rileytuttle/order66-pcb/order66/order66-back-pcb.png

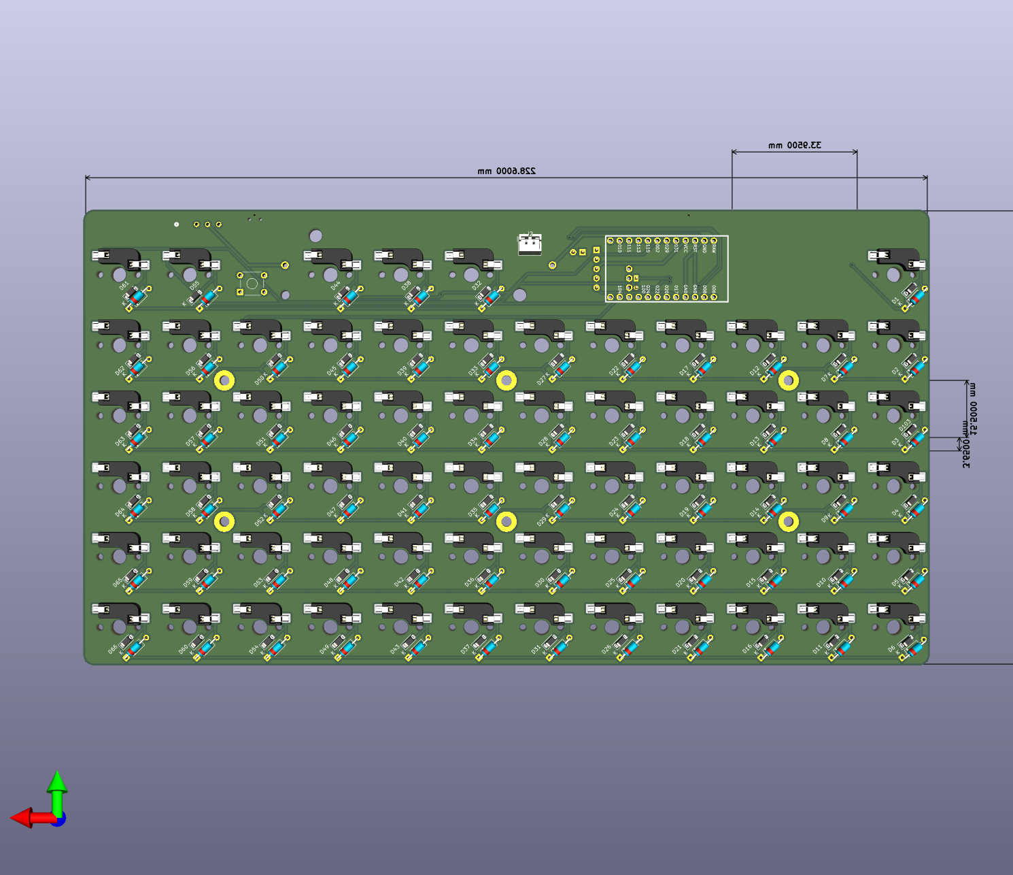
order66/order66-back-pcb.png
