rileytuttle/order66-pcb/order66/order66-front-pcb.png

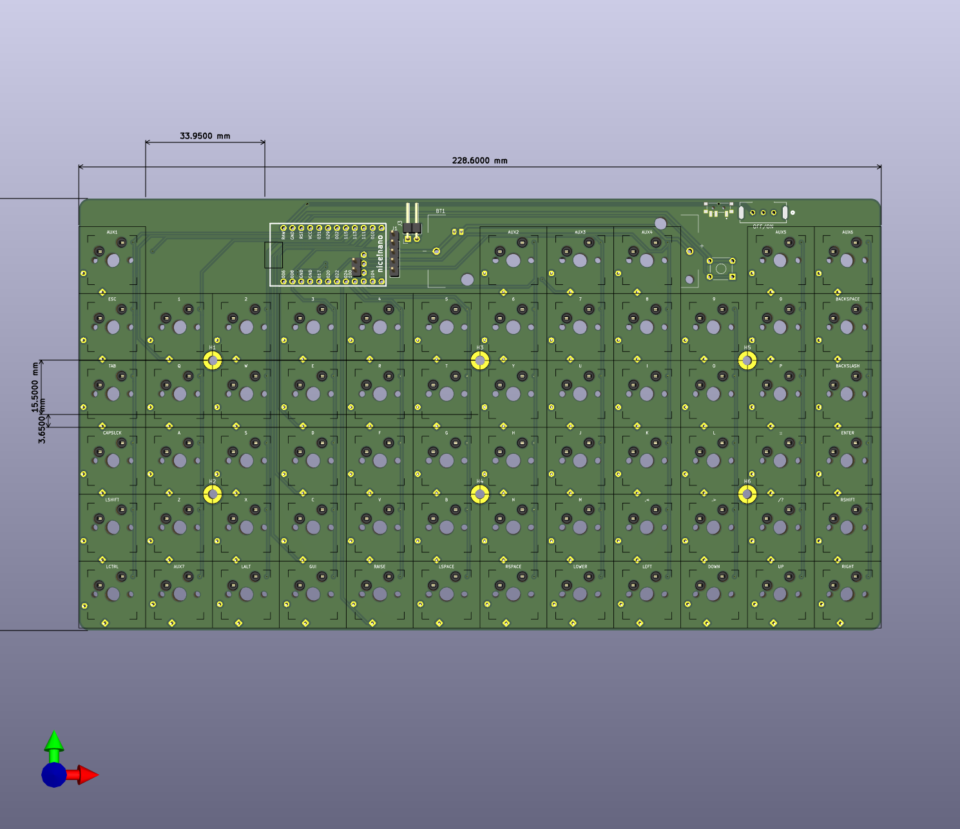
order66/order66-front-pcb.png
