rileytuttle/order66-pcb/order66/order66.kicad_pcb

## KiCad design order66/order66.kicad_pcb (2025-07-09)

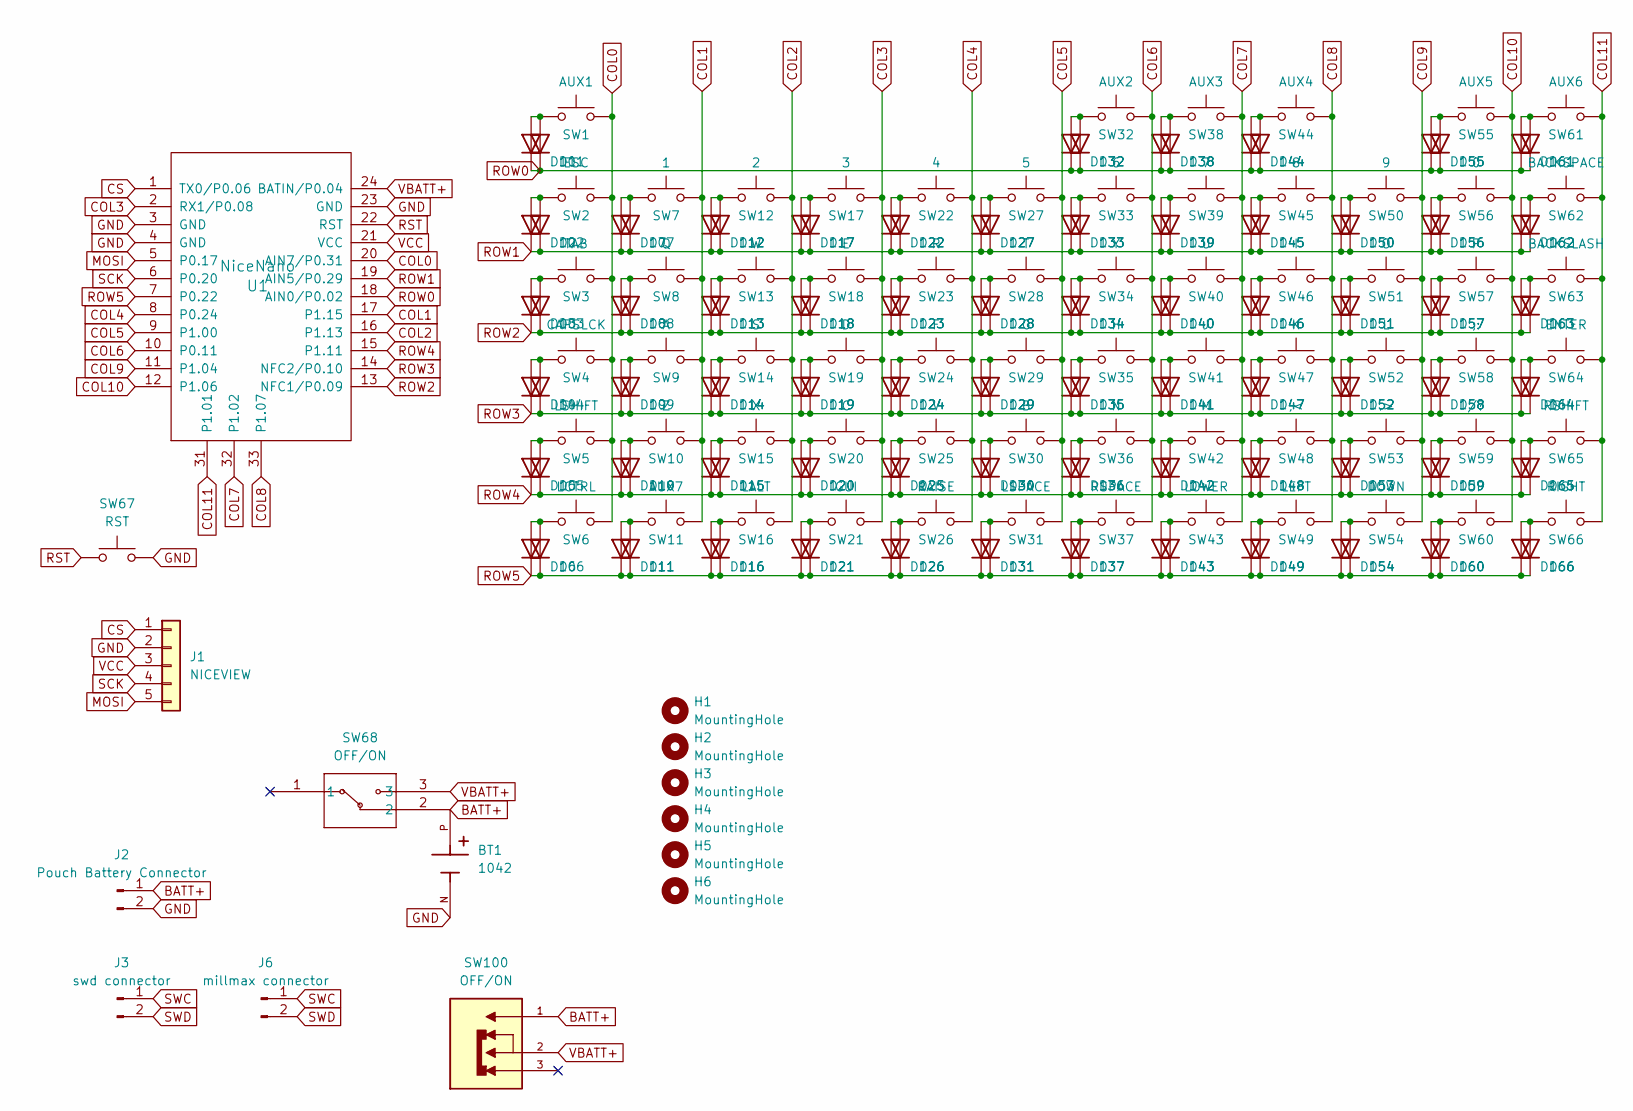
[picture p3: schematic order66.kicad_sch]

Parts:
BT1: 1042; BAT_1043P; PARTREV D
D1, D2, D3, D4, D5, D6, D7, D8, D9, D10, D11, D12, D13, D14, D15, D16, D17, D18, D19, D20, D21, D22, D23, D24, D25, D26, D27, D28, D29, D30, D31, D32, D33, D34, D35, D36, D37, D38, D39, D40, D41, D42, D43, D44, D45, D46, D47, D48, D49, D50, D51, D52, D53, D54, D55, D56, D57, D58, D59, D60, D61, D62, D63, D64, D65, D66: 1N4148; D_DO-35_SOD27_P7.62mm_Horizontal
D101, D102, D103, D104, D105, D106, D107, D108, D109, D110, D111, D112, D113, D114, D115, D116, D117, D118, D119, D120, D121, D122, D123, D124, D125, D126, D127, D128, D129, D130, D131, D132, D133, D134, D135, D136, D137, D138, D139, D140, D141, D142, D143, D144, D145, D146, D147, D148, D149, D150, D151, D152, D153, D154, D155, D156, D157, D158, D159, D160, D161, D162, D163, D164, D165, D166: 1N4148; D_SOD-123
H1, H2, H3, H4, H5, H6: MountingHole; MountingHole_2.7mm_M2.5
J1: NICEVIEW; PinHeader_1x05_P2.54mm_Vertical
J2: Pouch Battery Connector; JST_PH_B2B-PH-K_1x02_P2.00mm_Vertical
J3: swd connector; PinHeader_1x02_P2.54mm_Horizontal
J6: millmax connector; PinHeader_1x02_P2.54mm_Vertical
SW1: AUX1; MX-Hotswap-1U
SW2: ESC; MX-Hotswap-1U
SW3: TAB; MX-Hotswap-1U
SW4: CAPSLCK; MX-Hotswap-1U
SW5: LSHIFT; MX-Hotswap-1U
SW6: LCTRL; MX-Hotswap-1U
SW7: 1; MX-Hotswap-1U
SW8: Q; MX-Hotswap-1U
SW9: A; MX-Hotswap-1U
SW10: Z; MX-Hotswap-1U
SW11: AUX7; MX-Hotswap-1U
SW12: 2; MX-Hotswap-1U
SW13: W; MX-Hotswap-1U
SW14: S; MX-Hotswap-1U
SW15: X; MX-Hotswap-1U
SW16: LALT; MX-Hotswap-1U
SW17: 3; MX-Hotswap-1U
SW18: E; MX-Hotswap-1U
SW19: D; MX-Hotswap-1U
SW20: C; MX-Hotswap-1U
SW21: GUI; MX-Hotswap-1U
SW22: 4; MX-Hotswap-1U
SW23: R; MX-Hotswap-1U
SW24: F; MX-Hotswap-1U
SW25: V; MX-Hotswap-1U
SW26: RAISE; MX-Hotswap-1U
SW27: 5; MX-Hotswap-1U
SW28: T; MX-Hotswap-1U
SW29: G; MX-Hotswap-1U
SW30: B; MX-Hotswap-1U
SW31: LSPACE; MX-Hotswap-1U
SW32: AUX2; MX-Hotswap-1U
SW33: 6; MX-Hotswap-1U
SW34: Y; MX-Hotswap-1U
SW35: H; MX-Hotswap-1U
SW36: N; MX-Hotswap-1U
SW37: RSPACE; MX-Hotswap-1U
SW38: AUX3; MX-Hotswap-1U
SW39: 7; MX-Hotswap-1U
SW40: U; MX-Hotswap-1U
SW41: J; MX-Hotswap-1U
SW42: M; MX-Hotswap-1U
SW43: LOWER; MX-Hotswap-1U
SW44: AUX4; MX-Hotswap-1U
SW45: 8; MX-Hotswap-1U
SW46: I; MX-Hotswap-1U
SW47: K; MX-Hotswap-1U
SW48: ,<; MX-Hotswap-1U
SW49: LEFT; MX-Hotswap-1U
SW50: 9; MX-Hotswap-1U
SW51: O; MX-Hotswap-1U
SW52: L; MX-Hotswap-1U
SW53: .>; MX-Hotswap-1U
SW54: DOWN; MX-Hotswap-1U
SW55: AUX5; MX-Hotswap-1U
SW56: 0; MX-Hotswap-1U
SW57: P; MX-Hotswap-1U
SW58: ;:; MX-Hotswap-1U
SW59: /?; MX-Hotswap-1U
SW60: UP; MX-Hotswap-1U
SW61: AUX6; MX-Hotswap-1U
SW62: BACKSPACE; MX-Hotswap-1U
SW63: BACKSLASH; MX-Hotswap-1U
SW64: ENTER; MX-Hotswap-1U
SW65: RSHIFT; MX-Hotswap-1U
SW66: RIGHT; MX-Hotswap-1U
SW67: RST; SW_TH_Tactile_Omron_B3F-10xx
SW68: OFF/ON; EG1206A_EWI
SW100: OFF/ON; SW_SSSS811101; PARTREV N/A
U1: NiceNano; nice_nano

Connections:
BATT+: BT1.P, J2.1, SW68.2, SW100.1
COL0: SW1.2, SW2.2, SW3.2, SW4.2, SW5.2, SW6.2, U1.20 (AIN7/P0.31)
COL1: SW7.2, SW8.2, SW9.2, SW10.2, SW11.2, U1.17 (P1.15)
COL2: SW12.2, SW13.2, SW14.2, SW15.2, SW16.2, U1.16 (P1.13)
COL3: SW17.2, SW18.2, SW19.2, SW20.2, SW21.2, U1.2 (RX1/P0.08)
COL4: SW22.2, SW23.2, SW24.2, SW25.2, SW26.2, U1.8 (P0.24)
COL5: SW27.2, SW28.2, SW29.2, SW30.2, SW31.2, U1.9 (P1.00)
COL6: SW32.2, SW33.2, SW34.2, SW35.2, SW36.2, SW37.2, U1.10 (P0.11)
COL7: SW38.2, SW39.2, SW40.2, SW41.2, SW42.2, SW43.2, U1.32 (P1.02)
COL8: SW44.2, SW45.2, SW46.2, SW47.2, SW48.2, SW49.2, U1.33 (P1.07)
COL9: SW50.2, SW51.2, SW52.2, SW53.2, SW54.2, U1.11 (P1.04)
COL10: SW55.2, SW56.2, SW57.2, SW58.2, SW59.2, SW60.2, U1.12 (P1.06)
COL11: SW61.2, SW62.2, SW63.2, SW64.2, SW65.2, SW66.2, U1.31 (P1.01)
CS: J1.1, U1.1 (TX0/P0.06)
GND: BT1.N, J1.2, J2.2, SW67.2, U1.3 (GND), U1.4 (GND), U1.23 (GND)
MOSI: J1.5, U1.5 (P0.17)
unnamed: D1.2 (A), D101.2 (A), SW1.1
unnamed: D10.2 (A), D110.2 (A), SW10.1
unnamed: D11.2 (A), D111.2 (A), SW11.1
unnamed: D2.2 (A), D102.2 (A), SW2.1
unnamed: D3.2 (A), D103.2 (A), SW3.1
unnamed: D4.2 (A), D104.2 (A), SW4.1
unnamed: D5.2 (A), D105.2 (A), SW5.1
unnamed: D6.2 (A), D106.2 (A), SW6.1
unnamed: D7.2 (A), D107.2 (A), SW7.1
unnamed: D8.2 (A), D108.2 (A), SW8.1
unnamed: D9.2 (A), D109.2 (A), SW9.1
unnamed: D12.2 (A), D112.2 (A), SW12.1
unnamed: D13.2 (A), D113.2 (A), SW13.1
unnamed: D14.2 (A), D114.2 (A), SW14.1
unnamed: D15.2 (A), D115.2 (A), SW15.1
unnamed: D16.2 (A), D116.2 (A), SW16.1
unnamed: D17.2 (A), D117.2 (A), SW17.1
unnamed: D18.2 (A), D118.2 (A), SW18.1
unnamed: D19.2 (A), D119.2 (A), SW19.1
unnamed: D20.2 (A), D120.2 (A), SW20.1
unnamed: D21.2 (A), D121.2 (A), SW21.1
unnamed: D22.2 (A), D122.2 (A), SW22.1
unnamed: D23.2 (A), D123.2 (A), SW23.1
unnamed: D24.2 (A), D124.2 (A), SW24.1
unnamed: D25.2 (A), D125.2 (A), SW25.1
unnamed: D26.2 (A), D126.2 (A), SW26.1
unnamed: D27.2 (A), D127.2 (A), SW27.1
unnamed: D28.2 (A), D128.2 (A), SW28.1
unnamed: D29.2 (A), D129.2 (A), SW29.1
unnamed: D30.2 (A), D130.2 (A), SW30.1
unnamed: D31.2 (A), D131.2 (A), SW31.1
unnamed: D32.2 (A), D132.2 (A), SW32.1
unnamed: D33.2 (A), D133.2 (A), SW33.1
unnamed: D34.2 (A), D134.2 (A), SW34.1
unnamed: D35.2 (A), D135.2 (A), SW35.1
unnamed: D36.2 (A), D136.2 (A), SW36.1
unnamed: D37.2 (A), D137.2 (A), SW37.1
unnamed: D38.2 (A), D138.2 (A), SW38.1
unnamed: D39.2 (A), D139.2 (A), SW39.1
unnamed: D40.2 (A), D140.2 (A), SW40.1
unnamed: D41.2 (A), D141.2 (A), SW41.1
unnamed: D42.2 (A), D142.2 (A), SW42.1
unnamed: D43.2 (A), D143.2 (A), SW43.1
unnamed: D44.2 (A), D144.2 (A), SW44.1
unnamed: D45.2 (A), D145.2 (A), SW45.1
unnamed: D46.2 (A), D146.2 (A), SW46.1
unnamed: D47.2 (A), D147.2 (A), SW47.1
unnamed: D48.2 (A), D148.2 (A), SW48.1
unnamed: D49.2 (A), D149.2 (A), SW49.1
unnamed: D50.2 (A), D150.2 (A), SW50.1
unnamed: D51.2 (A), D151.2 (A), SW51.1
unnamed: D52.2 (A), D152.2 (A), SW52.1
unnamed: D53.2 (A), D153.2 (A), SW53.1
unnamed: D54.2 (A), D154.2 (A), SW54.1
unnamed: D55.2 (A), D155.2 (A), SW55.1
unnamed: D56.2 (A), D156.2 (A), SW56.1
unnamed: D57.2 (A), D157.2 (A), SW57.1
unnamed: D58.2 (A), D158.2 (A), SW58.1
unnamed: D59.2 (A), D159.2 (A), SW59.1
unnamed: D60.2 (A), D160.2 (A), SW60.1
unnamed: D61.2 (A), D161.2 (A), SW61.1
unnamed: D62.2 (A), D162.2 (A), SW62.1
unnamed: D63.2 (A), D163.2 (A), SW63.1
unnamed: D64.2 (A), D164.2 (A), SW64.1
unnamed: D65.2 (A), D165.2 (A), SW65.1
unnamed: D66.2 (A), D166.2 (A), SW66.1
ROW0: D1.1 (K), D32.1 (K), D38.1 (K), D44.1 (K), D55.1 (K), D61.1 (K), D101.1 (K), D132.1 (K), D138.1 (K), D144.1 (K), D155.1 (K), D161.1 (K), U1.18 (AIN0/P0.02)
ROW1: D2.1 (K), D7.1 (K), D12.1 (K), D17.1 (K), D22.1 (K), D27.1 (K), D33.1 (K), D39.1 (K), D45.1 (K), D50.1 (K), D56.1 (K), D62.1 (K), D102.1 (K), D107.1 (K), D112.1 (K), D117.1 (K), D122.1 (K), D127.1 (K), D133.1 (K), D139.1 (K), D145.1 (K), D150.1 (K), D156.1 (K), D162.1 (K), U1.19 (AIN5/P0.29)
ROW2: D3.1 (K), D8.1 (K), D13.1 (K), D18.1 (K), D23.1 (K), D28.1 (K), D34.1 (K), D40.1 (K), D46.1 (K), D51.1 (K), D57.1 (K), D63.1 (K), D103.1 (K), D108.1 (K), D113.1 (K), D118.1 (K), D123.1 (K), D128.1 (K), D134.1 (K), D140.1 (K), D146.1 (K), D151.1 (K), D157.1 (K), D163.1 (K), U1.13 (NFC1/P0.09)
ROW3: D4.1 (K), D9.1 (K), D14.1 (K), D19.1 (K), D24.1 (K), D29.1 (K), D35.1 (K), D41.1 (K), D47.1 (K), D52.1 (K), D58.1 (K), D64.1 (K), D104.1 (K), D109.1 (K), D114.1 (K), D119.1 (K), D124.1 (K), D129.1 (K), D135.1 (K), D141.1 (K), D147.1 (K), D152.1 (K), D158.1 (K), D164.1 (K), U1.14 (NFC2/P0.10)
ROW4: D5.1 (K), D10.1 (K), D15.1 (K), D20.1 (K), D25.1 (K), D30.1 (K), D36.1 (K), D42.1 (K), D48.1 (K), D53.1 (K), D59.1 (K), D65.1 (K), D105.1 (K), D110.1 (K), D115.1 (K), D120.1 (K), D125.1 (K), D130.1 (K), D136.1 (K), D142.1 (K), D148.1 (K), D153.1 (K), D159.1 (K), D165.1 (K), U1.15 (P1.11)
ROW5: D6.1 (K), D11.1 (K), D16.1 (K), D21.1 (K), D26.1 (K), D31.1 (K), D37.1 (K), D43.1 (K), D49.1 (K), D54.1 (K), D60.1 (K), D66.1 (K), D106.1 (K), D111.1 (K), D116.1 (K), D121.1 (K), D126.1 (K), D131.1 (K), D137.1 (K), D143.1 (K), D149.1 (K), D154.1 (K), D160.1 (K), D166.1 (K), U1.7 (P0.22)
RST: SW67.1, U1.22 (RST)
SCK: J1.4, U1.6 (P0.20)
SWC: J3.1, J6.1
SWD: J3.2, J6.2
VBATT+: SW68.3, SW100.2, U1.24 (BATIN/P0.04)
VCC: J1.3, U1.21 (VCC)

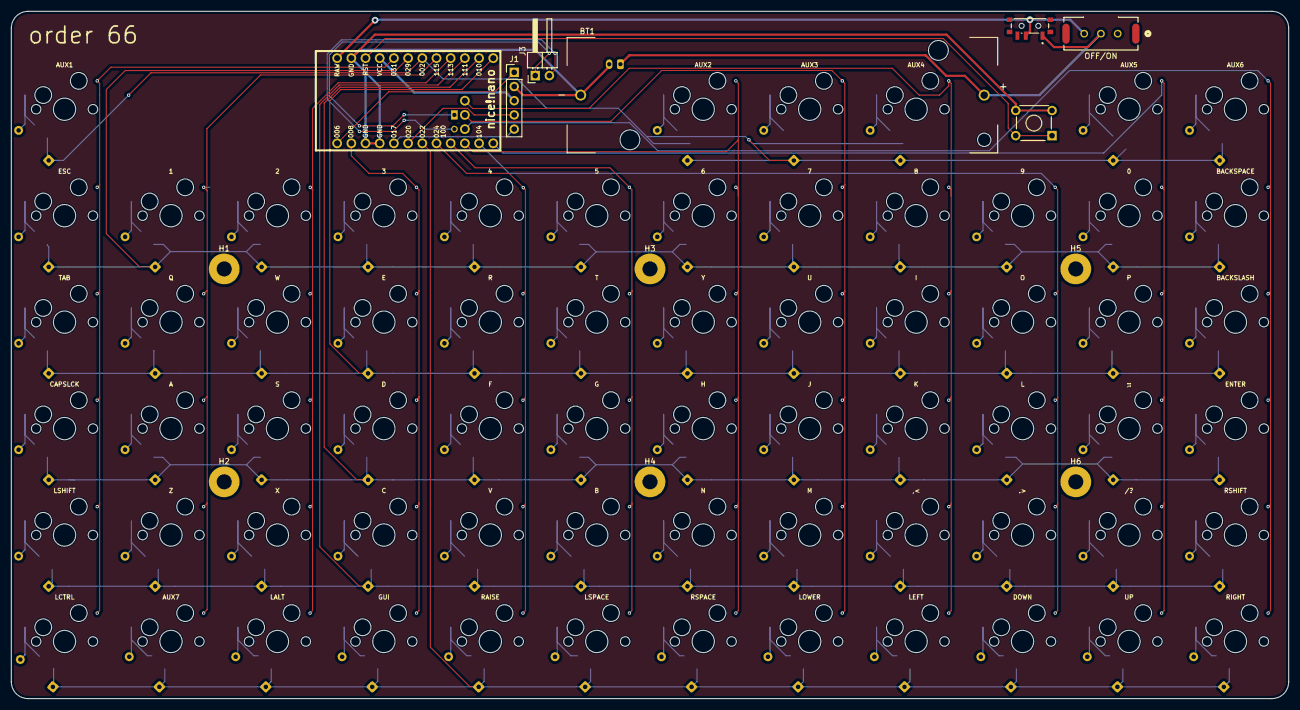
[picture p4: board order66.kicad_pcb from above]

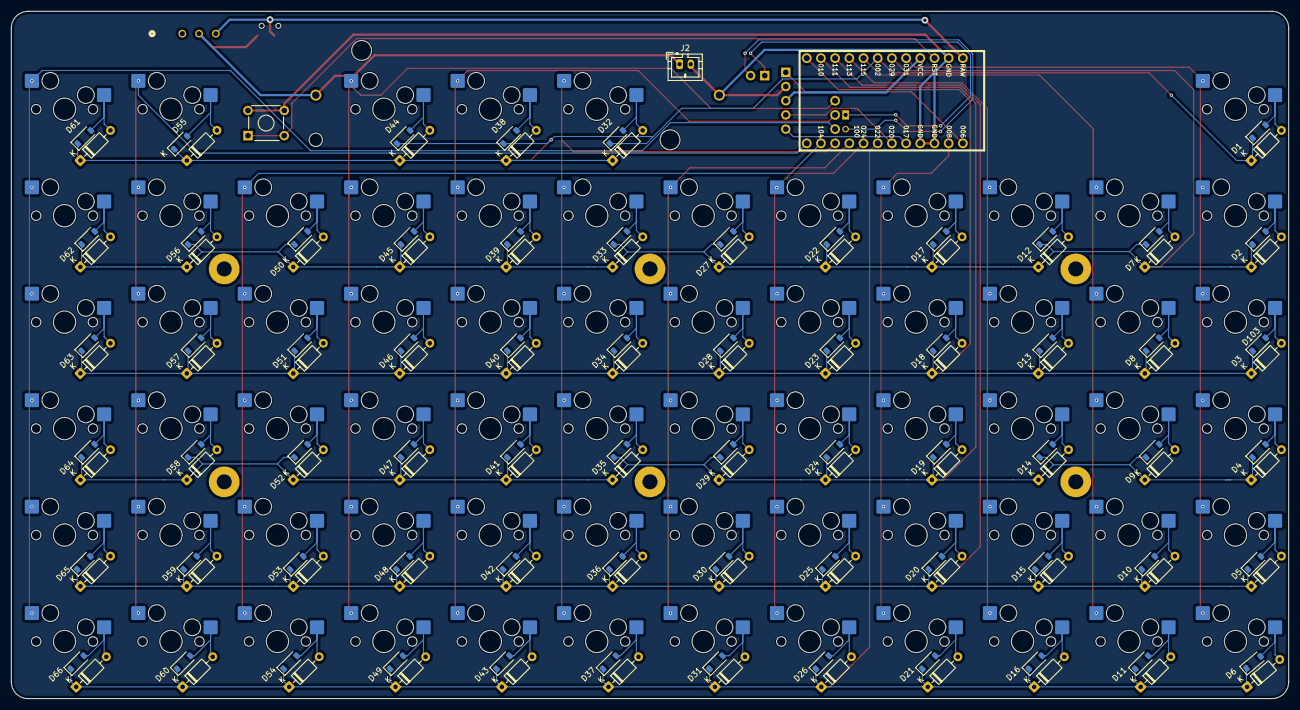
[picture p5: board order66.kicad_pcb from below]

Board: 2 copper layers, 228.6 x 123.0 mm, 213 parts (199 on the bottom side), 94 nets.
