rileytuttle/order66-pcb/(commit log)

2025-06-26 Trying though hole diodes (#1)
    * changed to through hole diodes in schematic
    * moved to more through hole components and rerouted traces
    * trying to generate bom
    * reordered the switch and diode numberings to be in order
    * fixing and checking on board design rules to match pcb fabrication
    * starting work on case
    * reorganizing now that case files exists
    * added support for millmax spring loaded swd pins for bootloader support
    [order66-bom.csv, order66.kicad_pcb, order66.kicad_sch]
2025-06-26 Trying smd and through hole diodes same time (#2)
    * added the smd sod 123 package diode symbols. havent placed/routed all the footprints yet but seems to be okay. need to figure out what I want to do with the silkscreen references. probably should just place the base numbered one and dont use the other
    * placed all diode footprints. need to sort out the silkscreen overlaps
    * added the other version of power switch that I have as well just in case
    [order66.kicad_pcb, order66.kicad_sch]
2025-06-26 updated pcb front back images and bom
    [order66-bom.csv]
2025-06-30 adding both an order 66 logo and a connector for the jlink but that needs work
    [order66.kicad_pcb, order66.kicad_sch]
2025-06-30 removing the connector for the link for now
    [order66.kicad_pcb, order66.kicad_sch]
2025-07-01 suring up before pcb fab
2025-07-09 adding some more dimensions to the pcb to aid case design
    [order66.kicad_pcb]
2025-07-18 Working on case after receiving pcb (#10)
    * adds the case and keygrid
    * fixes #5: fixing the switch pass through in case
2025-08-19 adding a 3d printed jig to hold the pcb so that I could mill out the legs of the power switch I have
    [power-switch-fix-jig.scad]
2025-08-27 adding the thumb keyboard to this repo for now to share the libraries but really I should move to its own repo. I will do that another time
    [thumb-keyboard.kicad_pcb, thumb-keyboard.kicad_sch]
2025-08-27 going to try reducing the slot diam
    [thumb-keyboard.kicad_pcb, thumb-keyboard.kicad_sch]
2025-08-27 Added ws2812b leds to thumb keyboard. they may be too tall. I may have to switch to the 222AMVBAR tactile switches and space everything out like a centimeter more. that would be a lot of work but wou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
    [thumb-keyboard.kicad_pcb, thumb-keyboard.kicad_sch]
2025-09-05 working on different switches. last commit before adding the B3F-1000 switch option and extending the x gap from 10 - 12 mm
    [thumb-keyboard.kicad_pcb, thumb-keyboard.kicad_sch]
2025-09-05 first commit after change to branch with optional B3F-1000 switches. footprint is going to be 144x60
    [thumb-keyboard.kicad_pcb, thumb-keyboard.kicad_sch]
2025-09-05 have something that looks alright. max size of 144x60mm. A little concerning how messy it is though
    [thumb-keyboard.kicad_pcb, thumb-keyboard.kicad_sch]
2025-09-05 sent out v1.0 pcb order
    [thumb-keyboard.kicad_pcb, thumb-keyboard.kicad_sch]
2025-09-05 staring removal of thumming board specific files
    [thumb-keyboard.kicad_pcb, thumb-keyboard.kicad_sch]
2025-11-05 adding the power connector 3d model
